pollen-robotics/orbita/(list of files, cad)

Other CAD files:
orbita-sdk/orbita_sdk/mlpreg.obj
