pollen-robotics/orbita/(threads)

Thread 3 (2020-05-14):

Add temperature safety for Orbita motors

pierre-rouanet, 2020-05-14:
* Turn off motors when temperature reaches a threshold?

pierre-rouanet, 2021-01-27:
Fixed in https://github.com/pollen-robotics/orbita/commit/625aee91311fd07c385d565e2d847e29f073a901

Closed 2021-01-27.
