pollen-robotics/orbita/firmware/boards/Orbita_MainBoard_Schematic.PDF

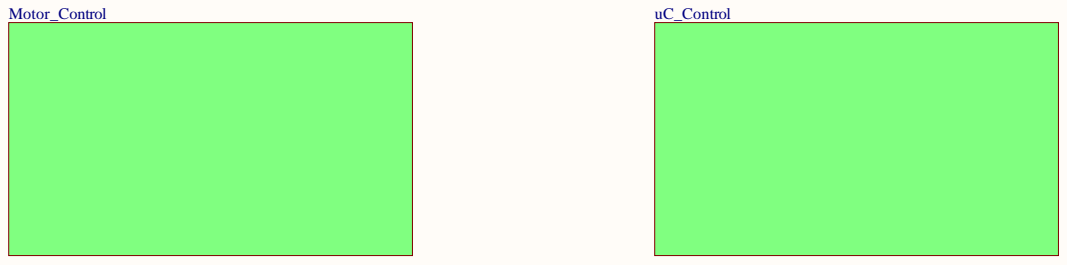
[picture p6: page 1]

Drawn by Cyril SAGONERO

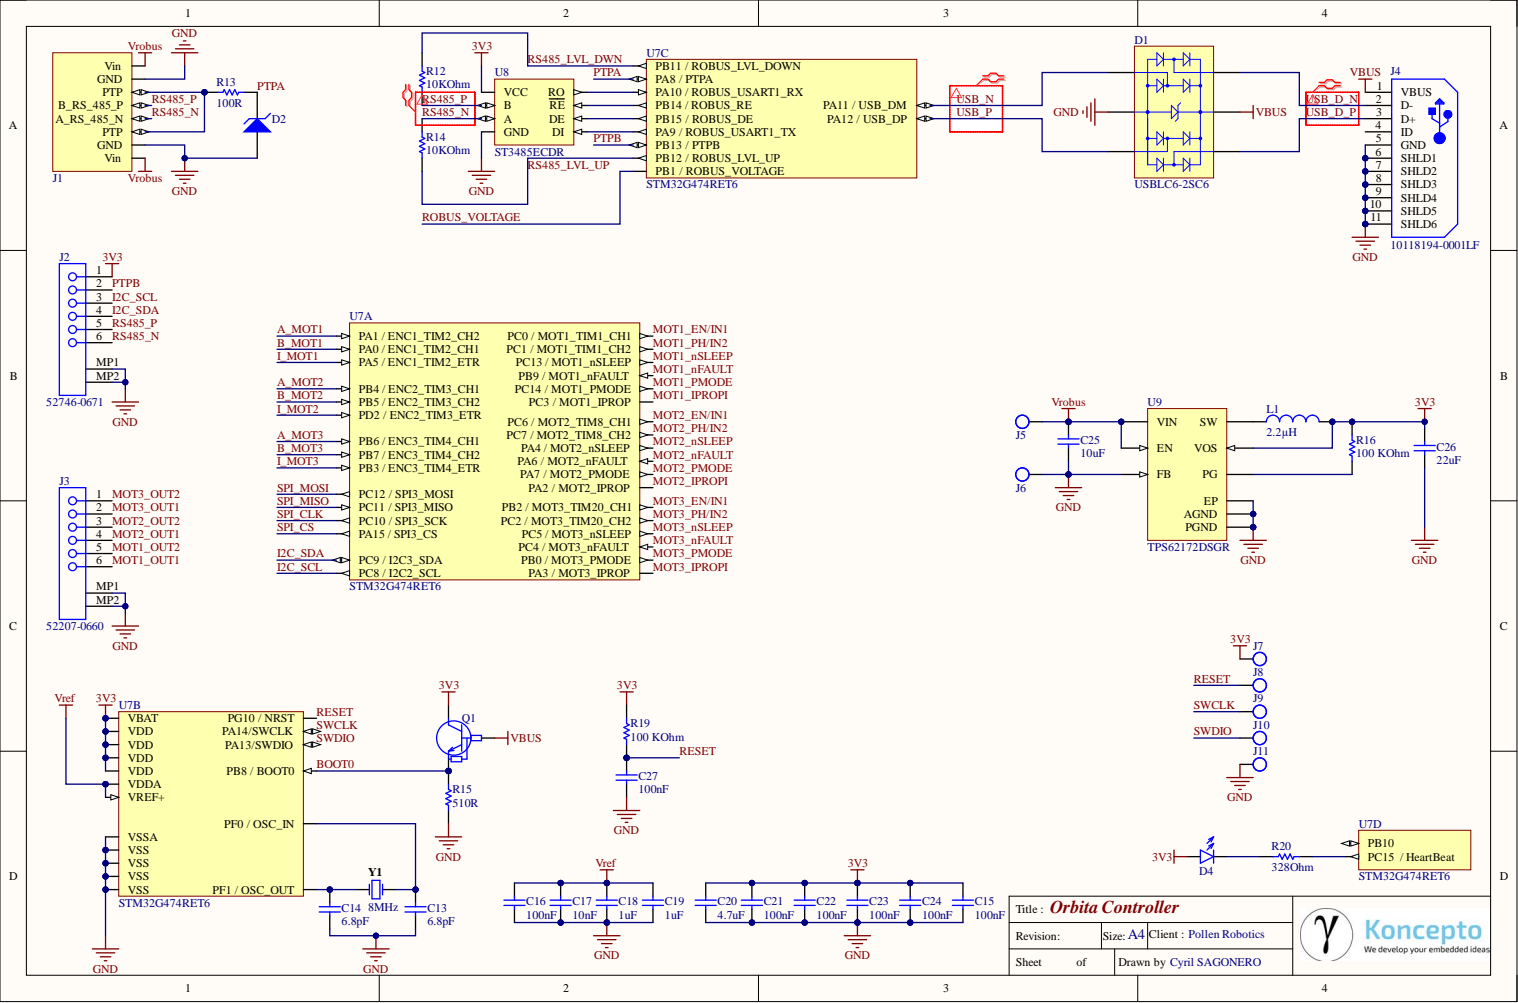
[picture p7: page 2]

Vref
VBAT VSS VDD VSSA VDDA VSS VDD VSS VDD VSS VDD

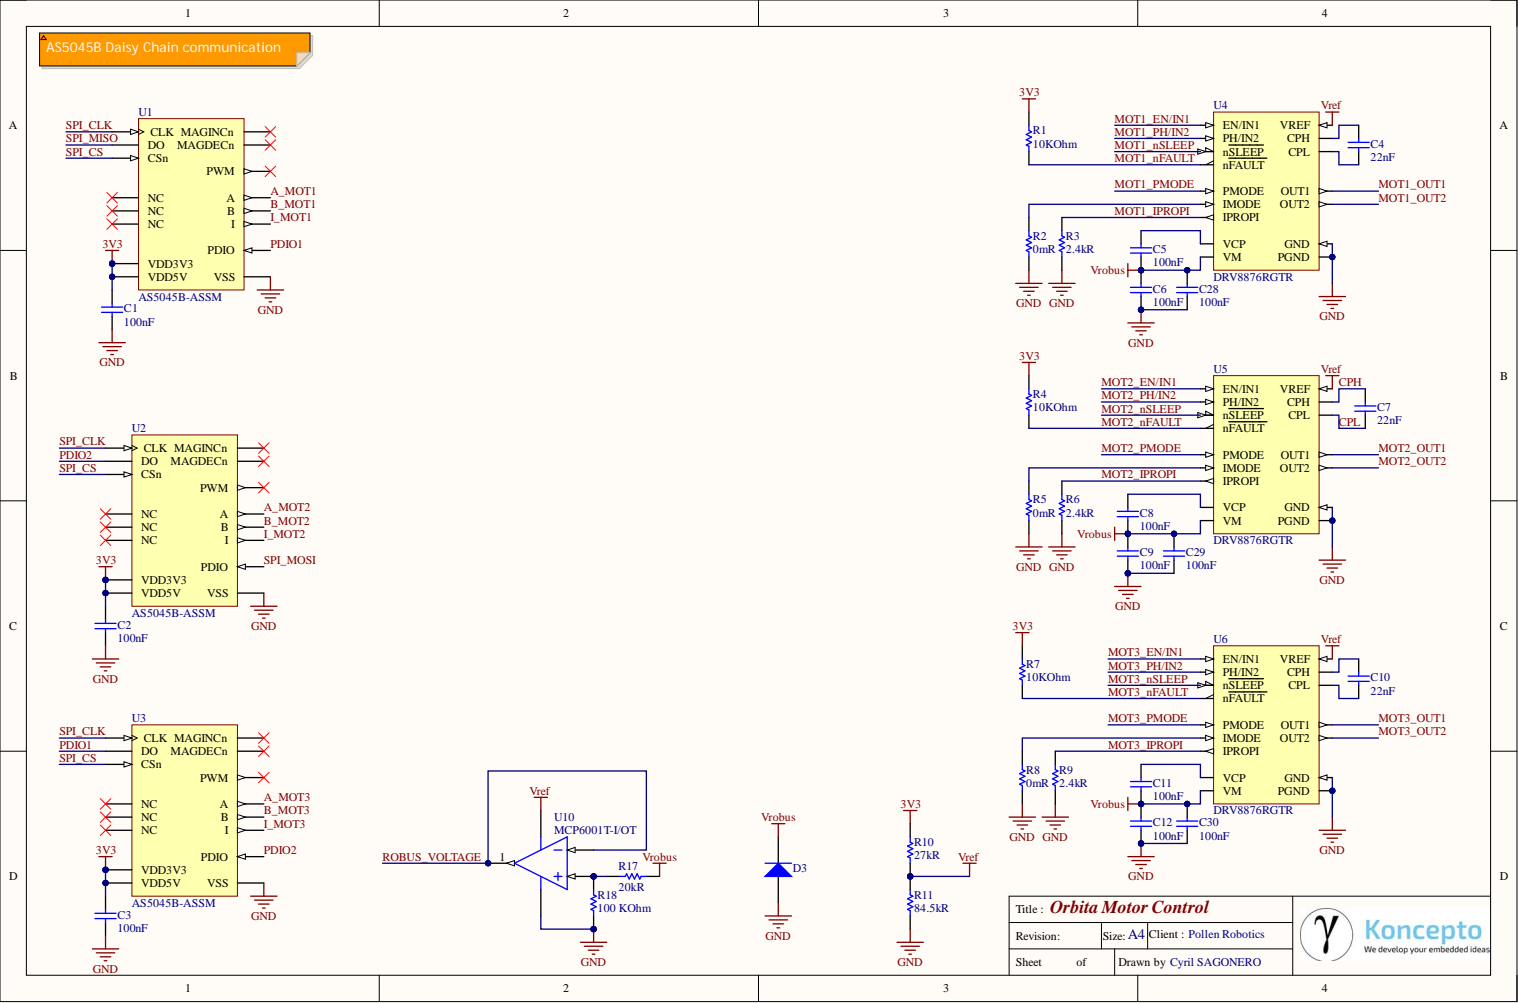
[picture p8: page 3]
