pollen-robotics/orbita/firmware/boards/Orbita_SecondaryBoard_Schematic.PDF

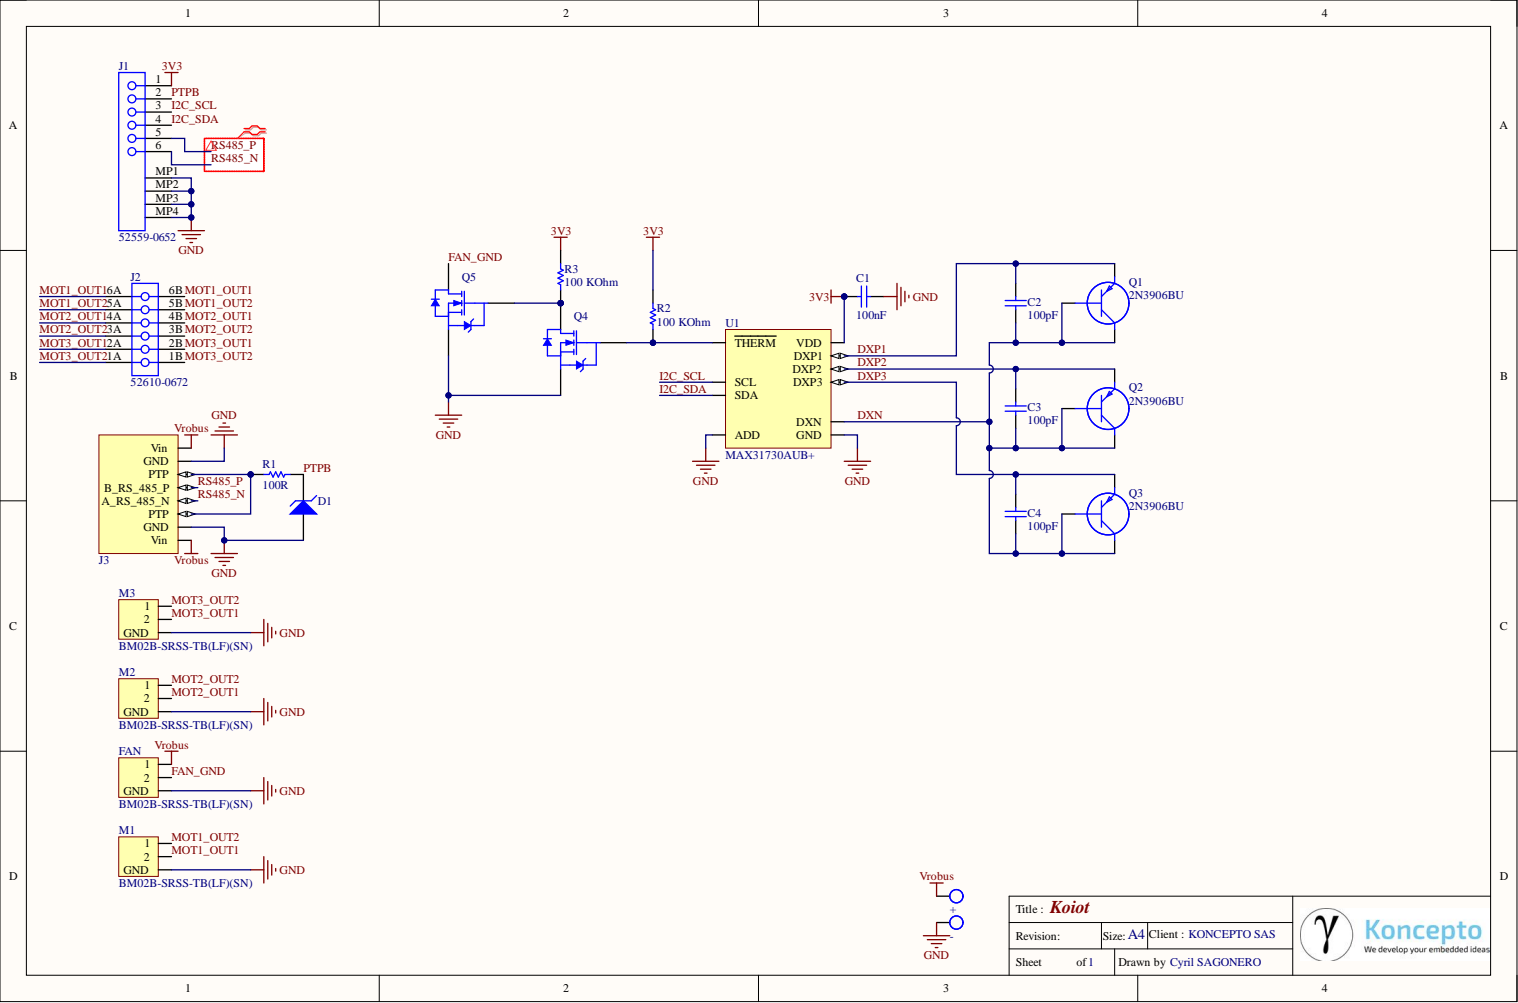
[picture p9: page 1]

MP2
MP3
MP4

DXP2
DXP3

DXN

Drawn by Cyril SAGONERO
