pollen-robotics/orbita/firmware/inc/main.h

#define RS485_RE_Pin GPIO_PIN_14
#define RS485_RE_GPIO_Port GPIOB
#define RS485_DE_Pin GPIO_PIN_15
#define RS485_DE_GPIO_Port GPIOB
#define RS485_TX_Pin GPIO_PIN_9
#define RS485_TX_GPIO_Port GPIOA
#define RS485_RX_Pin GPIO_PIN_10
#define RS485_RX_GPIO_Port GPIOA
#define MOT1_EN_Pin GPIO_PIN_13
#define MOT1_EN_GPIO_Port GPIOC
#define MOT1_PMODE_Pin GPIO_PIN_14
#define MOT1_PMODE_GPIO_Port GPIOC
#define HeartBeat_Pin GPIO_PIN_15
#define HeartBeat_GPIO_Port GPIOC
#define RESET_Pin GPIO_PIN_10
#define RESET_GPIO_Port GPIOG
#define MOT1_IN1_Pin GPIO_PIN_0
#define MOT1_IN1_GPIO_Port GPIOC
#define MOT1_IN2_Pin GPIO_PIN_1
#define MOT1_IN2_GPIO_Port GPIOC
#define MOT3_IN2_Pin GPIO_PIN_2
#define MOT3_IN2_GPIO_Port GPIOC
#define MOT1_IPROP_Pin GPIO_PIN_3
#define MOT1_IPROP_GPIO_Port GPIOC
#define MOT2_IPROP_Pin GPIO_PIN_2
#define MOT2_IPROP_GPIO_Port GPIOA
#define MOT3_IPROP_Pin GPIO_PIN_3
#define MOT3_IPROP_GPIO_Port GPIOA
#define MOT2_EN_Pin GPIO_PIN_4
#define MOT2_EN_GPIO_Port GPIOA
#define ENC1_TIM2_ETR_Pin GPIO_PIN_5
#define ENC1_TIM2_ETR_GPIO_Port GPIOA
#define MOT2_nFAULT_Pin GPIO_PIN_6
#define MOT2_nFAULT_GPIO_Port GPIOA
#define MOT2_nFAULT_EXTI_IRQn EXTI9_5_IRQn
#define MOT2_PMODE_Pin GPIO_PIN_7
#define MOT2_PMODE_GPIO_Port GPIOA
#define MOT3_nFAULT_Pin GPIO_PIN_4
#define MOT3_nFAULT_GPIO_Port GPIOC
#define MOT3_EN_Pin GPIO_PIN_5
#define MOT3_EN_GPIO_Port GPIOC
#define MOT3_PMODE_Pin GPIO_PIN_0
#define MOT3_PMODE_GPIO_Port GPIOB
#define ROBUS_VOLTAGE_Pin GPIO_PIN_1
#define ROBUS_VOLTAGE_GPIO_Port GPIOB
#define MOT3_IN1_Pin GPIO_PIN_2
#define MOT3_IN1_GPIO_Port GPIOB
#define MOT2_IN1_Pin GPIO_PIN_6
#define MOT2_IN1_GPIO_Port GPIOC
#define MOT2_IN2_Pin GPIO_PIN_7
#define MOT2_IN2_GPIO_Port GPIOC
#define AS5045B_SS_Pin GPIO_PIN_15
#define AS5045B_SS_GPIO_Port GPIOA
#define AS5045B_SCK_Pin GPIO_PIN_10
#define AS5045B_SCK_GPIO_Port GPIOC
#define AS5045B_MISO_Pin GPIO_PIN_11
#define AS5045B_MISO_GPIO_Port GPIOC
#define AS5045B_MOSI_Pin GPIO_PIN_12
#define AS5045B_MOSI_GPIO_Port GPIOC
#define ENC3_TIM4_ETR_Pin GPIO_PIN_3
#define ENC3_TIM4_ETR_GPIO_Port GPIOB
#define ENC2_TIM3_CH1_Pin GPIO_PIN_4
#define ENC2_TIM3_CH1_GPIO_Port GPIOB
#define ENC2_TIM3_CH2_Pin GPIO_PIN_5
#define ENC2_TIM3_CH2_GPIO_Port GPIOB
#define ENC3_TIM4_CH1_Pin GPIO_PIN_6
#define ENC3_TIM4_CH1_GPIO_Port GPIOB
#define ENC3_TIM4_CH2_Pin GPIO_PIN_7
#define ENC3_TIM4_CH2_GPIO_Port GPIOB
#define BOOT0_Pin GPIO_PIN_8
#define BOOT0_GPIO_Port GPIOB
#define MOT1_nFAULT_Pin GPIO_PIN_9
#define MOT1_nFAULT_GPIO_Port GPIOB
#define MOT1_nFAULT_EXTI_IRQn EXTI9_5_IRQn
#define LED_Pin GPIO_PIN_15
#define LED_GPIO_Port GPIOC
