pollen-robotics/orbita/firmware/modules/orbita/MAX31730.c

/*
 * MAX31730.c
 *
 *  Created on: 10 avr. 2020
 *      Author: Cyril SAGONERO
 *		Company: Koncepto (https://koncepto.io)
 */


#include "MAX31730.h"

static void MAX31730_Read(uint8_t RegAddr, uint8_t *RecBuffer, uint16_t Length);
static void MAX31730_Write(uint8_t RegAddr, uint8_t SendData);
static float temp_conv(uint16_t );

MAX31730_functions MAX31730={
		ReadTemp,
		SetTreshold,
		SetFilter,
		HighTresholdStat,
		SensStatus,
};

uint8_t SensStatus(void){
	uint8_t Status=0;
	MAX31730_Read(DiodeFaultStat_Addr, &Status, 1);
	return Status;
}

void SetFilter(FunctionalState FilterStat){
	if(FilterStat == ENABLE){
		MAX31730_Write(FilterEnable_Addr, 0x0E);
	}else{
		MAX31730_Write(FilterEnable_Addr, 0x00);
	}
}

void SetTreshold(int8_t Temp){
	MAX31730_Write(R1T_HiLimitMSB_Addr, Temp);
	MAX31730_Write(R1L_HiLimitLSB_Addr, 0);
	MAX31730_Write(R2T_HiLimitMSB_Addr, Temp);
	MAX31730_Write(R2L_HiLimitLSB_Addr, 0);
	MAX31730_Write(R3T_HiLimitMSB_Addr, Temp);
	MAX31730_Write(R3L_HiLimitLSB_Addr, 0);
	MAX31730_Write(ThermPinMask_Addr, 0b00000000);
}

uint8_t HighTresholdStat(void){
	uint8_t HighStatus=0;
	MAX31730_Read(T_StatusHigh_Addr, &HighStatus, 1);
	return HighStatus;
}

void ReadTemp(float *Temp){
	uint16_t temperature[3]={0};
	MAX31730_Read(Remote1TempMSB_Addr,(uint8_t *) &temperature[0], 2);
	MAX31730_Read(Remote2TempMSB_Addr,(uint8_t *) &temperature[1], 2);
	MAX31730_Read(Remote3TempMSB_Addr,(uint8_t *) &temperature[2], 2);
	Temp[0]=temp_conv(temperature[0]);
	Temp[1]=temp_conv(temperature[1]);
	Temp[2]=temp_conv(temperature[2]);
}

static void MAX31730_Read(uint8_t RegAddr, uint8_t *RecBuffer, uint16_t Length){
	HAL_I2C_Master_Transmit(&hi2c3, MAX31730_addr, &RegAddr, 1, 1000); 			// Register to read
	HAL_I2C_Master_Receive(&hi2c3, MAX31730_addr, RecBuffer, Length, 1000);		// Read
}

static void MAX31730_Write(uint8_t RegAddr, uint8_t SendData){
	uint8_t data[2]="";
	data[0]=RegAddr;
	data[1]=SendData;
	HAL_I2C_Master_Transmit(&hi2c3, MAX31730_addr, data, 2, 1000);
}

static float temp_conv(uint16_t raw_temp){
	uint16_t temp = ((((raw_temp) & 0x00FF)<<8) | (((raw_temp)&0xFF00)>>8))>>4;
	volatile float realtemp=(temp&0x01)*0.0625 + \
			((temp&0x02)>>1)*0.125 + \
			((temp&0x04)>>2)*0.25 + \
			((temp&0x08)>>3)*0.5 + \
			((temp&0x10)>>4)*1 + \
			((temp&0x20)>>5)*2 + \
			((temp&0x40)>>6)*4 + \
			((temp&0x80)>>7)*8 + \
			((temp&0x100)>>8)*16 + \
			((temp&0x200)>>9)*32 + \
			((temp&0x400)>>10)*64;
	if(raw_temp&0x800){
		realtemp=0-realtemp;
	}
	return realtemp;
}
