pollen-robotics/orbita/(commit log)

2019-04-26 Notebook to calculate PID parameters of the motors
2019-04-26 Notebook to control and test the spherical actuator
2019-04-29 Program using quaternions to rotate X,Y and Z axis
2019-04-30 Same method to print q12 and q13
2019-05-17 Program to control the actuator with an IMU on the non-actuated version
2019-05-20 Moved Motor_PID notebook in notebooks directory
2019-05-21 Creation of a module to create a class "Actuator" and use its methods to get the new frame or the angles of the disks
2019-05-21 Add a method to get the new frame from a quaternion instead of a vector and an angle
2019-05-21 Changes initial values of the actuator's parameters
2019-05-21 Import Actuator class in __init__.py file to import it easier
2019-05-21 New notebook to control the actuator with the spherical_joint lib
2019-05-21 Create a python script to control the actuator with an IMU
2019-05-23 Add a code to make the actuator draw a circle and rotate at the same time
2019-05-28 Add new demo to keep the platform horizontal with IMU stuck on it
2019-06-14 change the vector used to try the actuator
2019-06-18 Change actuator and PID parameters
2019-06-24 Solve a bug when the difference between current position and the next one is 180°
2019-07-11 New notebook to control a head on the actuator
2019-10-04 Add new PID test
2019-10-04 Notebook to control the Actuator v2
2019-10-04 Allow the user to choose a different initial frame R0
2019-10-08 Notebook to play drums with the actuator as a wrist
2019-10-09 zero() function makes the actuator find its initial position
2019-10-09 Make the actuator play xylophone songs
2019-10-15 Add zero4() function to find zeros with the head on the actuator
2019-10-18 Modification on PID, current limit. Add a minjerk trajectory function. Add a new demo. WIP on zero function
2019-10-29 Find zero positions with buttons
2019-11-08 Add a cell to find zeros with stops in gears
2019-11-18 Change encoder resolution and modify the cell to find zeros with stop in gears
2019-11-20 Fix a degrees/radians mistake
    [orbita.py]
2020-01-27 Add actuator unit test.
2020-01-28 Fix get angles from quat.
    [orbita.py]
2020-04-16 move custom framework package link from board to project.
2020-04-16 Fix board define issue
2020-05-04 Manage sensor position and manage all motors.
    [stm32g4x.cfg]
2020-05-07 Clean posistion sensor driver
2020-05-12 add motor temperature management
2020-05-12 update default PID values
2020-05-19 remove motor struct from luos
2020-05-26 Add temperature sensor filter and threshold
2020-05-27 Remove d from default PID.
2020-05-27 Set the fan threshold to 40°C.
2020-06-03 Fix a table error on temperature
2020-06-29 Add temperature limit shutdown.
2020-06-29 Adjust pid.
2020-07-07 Switch all position direction to be in direct mode.
2021-01-20 Remove all motor code and prepare for luos v1.
2021-01-22 Add Led pin.
2021-01-25 Impl. limits and pid.
2021-01-25 max torque.
2021-01-25 clip ma torque.
2021-01-25 Fully implement pid.
2021-01-26 Bugfix in temp shutdown.
    [orbita.c, orbita.h]
2021-01-27 Bugfix in set pid.
    [orbita.c]
2021-01-28 Fix motor orientation.
2021-01-29 Fix temperature order.
2021-01-29 Add magnetic quality get.
2021-02-03 Change compliant to torque_enable.
2021-02-11 Use timer for asserv.
2021-03-01 Add fan trigger get/set messages.
2021-03-09 Add get orbita fan state.
2021-03-09 Fix PID.
2021-03-15 Update pid computation.
2021-03-15 Update PID gains.
2021-04-08 Update PID.
2022-02-18 Setup DMA.
2022-02-21 Handle missing read reg.
    [message.c, message.h, orbita.c]
2022-02-21 Add missing read reg.
    [orbita.c, orbita.h]
2022-02-21 Fix torque enable.
2022-02-25 Handles error in low-level.
    [serial_io.py]
2022-02-25 Fix error handling issue in firmware.
    [message.c, message.h, orbita.c, rs485_com.c]
2022-02-25 Implement high-level API.
    [mlpreg.obj]
2022-03-01 Add PID, Zero, and ID in EEPROM.
2022-03-01 Store TemperatureShutdown in Flash.
2022-03-02 pid tuning
2022-03-02 pid seems ok
2022-03-03 Fix GPIOs on motor 3.
2022-03-03 Fix gpio for motor control.
2022-03-10 Bugfix in kinematics.
2022-03-14 Adjust default PID value.
2022-03-15 Handles fan trigger temp.
2022-03-15 Add temperature safety.
2022-03-15 Bugfix when accessing single value reg.
    [orbita.py]
2022-03-15 Handle temp error/shutdown as dxl.
    [orbita.c, orbita.h, register.py]
2022-03-15 Only turn off the torque for shutdown.
